nguyenvanan6724-hash/lam-tiep/kicad/esp32c6_recorder/bom.csv

Ref | Value | Footprint | Spec | MPN | Note | Qty | DNP
C26 | 10uF | Capacitor_SMD:C_0805_2012Metric | 25V X5R |  | Đặt sát chân VCC của U8 (TP4056) | 1
C27 | 10uF | Capacitor_SMD:C_0805_2012Metric | 10V X5R |  | Sát chân BAT | 1
C28 | 10uF | Capacitor_SMD:C_0603_1608Metric | 10V X5R | GRM188R61A106ME69 | Sát chân VIN (10) – GND (8) | 1
C29 | 22uF | Capacitor_SMD:C_0805_2012Metric | 10V X5R |  |  | 1
C30 | 22uF | Capacitor_SMD:C_0603_1608Metric | 10V X5R | GRM188R61A226ME15 | Sát chân VOUT (6) | 1
C31 | 22uF | Capacitor_SMD:C_0603_1608Metric | 10V X5R | GRM188R61A226ME15 |  | 1
C32 | 22uF | Capacitor_SMD:C_0805_2012Metric | 10V X5R |  | Sát chân 3V3 (pin 2) của module | 1
C33 | 100nF | Capacitor_SMD:C_0603_1608Metric |  |  | Sát chân 3V3 (pin 2) | 1
C34 | 1uF | Capacitor_SMD:C_0603_1608Metric |  |  | EN: τ = 10k × 1µF = 10 ms | 1
C35 | 100nF | Capacitor_SMD:C_0603_1608Metric |  |  | Sát chân IO2 | 1
C36 | 100nF | Capacitor_SMD:C_0603_1608Metric |  |  | Sát chân VCC (16) | 1
C37 | 100nF | Capacitor_SMD:C_0603_1608Metric |  |  | Sát chân V3 (4) | 1
C38 | 10uF | Capacitor_SMD:C_0805_2012Metric | 10V X5R |  | Sát chân VDD (4) của khe thẻ | 1
C39 | 100nF | Capacitor_SMD:C_0603_1608Metric |  |  | Sát chân VDD (4) | 1
C40 | 10uF | Capacitor_SMD:C_0805_2012Metric | 10V X5R |  |  | 1
C41 | 100nF | Capacitor_SMD:C_0603_1608Metric |  |  | Sát header MIC1 | 1
C42 | 100nF | Capacitor_SMD:C_0603_1608Metric |  |  | Sát header OLED | 1
C43 | 100nF | Capacitor_SMD:C_0603_1608Metric |  |  | Sát header MIC2 | 1
D3 | RED | LED_SMD:LED_0603_1608Metric |  |  | Sáng = đang sạc | 1
D4 | GREEN | LED_SMD:LED_0603_1608Metric |  |  | Sáng = sạc đầy | 1
D5 | SS34 | Diode_SMD:D_SMA |  | SS34 (hoặc SS14/SS24, cùng SMA) | Schottky ≥ 1 A | 1
J4 | USB-C 16P | Connector_USB:USB_C_Receptacle_HRO_TYPE-C-31-M-12 |  | HRO TYPE-C-31-M-12 | Đối chiếu đúng mã đầu cắm trước khi làm PCB | 1
J5 | microSD (DM3AT) | Connector_Card:microSD_HC_Hirose_DM3AT-SF-PEJM5 |  | Hirose DM3AT-SF-PEJM5 | Nếu đổi khe thẻ khác thì đổi cả footprint | 1
J6 | OLED I2C | Connector_PinSocket_2.54mm:PinSocket_1x04_P2.54mm_Vertical |  | Header cái 1x4 2.54 mm | Kiểm thứ tự chân: có module đảo VCC/GND | 1
J7 | LiPo 1S (có PCM) | Connector_JST:JST_PH_S2B-PH-K_1x02_P2.00mm_Horizontal |  | JST S2B-PH-K-S | Đo cực tính dây pin trước khi cắm | 1
J8,J10 | INMP441 hàng A | Connector_PinSocket_2.54mm:PinSocket_1x03_P2.54mm_Vertical |  | Header cái 1x3 2.54 mm | Đối chiếu thứ tự chân và đo khoảng cách 2 hàng chân của module | 2
J9,J11 | INMP441 hàng B | Connector_PinSocket_2.54mm:PinSocket_1x03_P2.54mm_Vertical |  | Header cái 1x3 2.54 mm | Đối chiếu thứ tự chân module | 2
L2 | 0.47uH | Inductor_SMD:L_Murata_DFE201610P | Isat ≥ 4 A, DCR ≤ 30 mΩ | Murata DFE201612E-R47M (hoặc Coilcraft XFL4015-471ME + đổi footprint) |  | 1
Q4,Q5 | MMBT3904 | Package_TO_SOT_SMD:SOT-23 |  |  |  | 2
Q6 | AO3401A | Package_TO_SOT_SMD:SOT-23 |  | AO3401A (Alpha&Omega) | D ở phía pin, S ở phía tải (bắt buộc đúng chiều) | 1
R37,R38 | 5.1k | Resistor_SMD:R_0603_1608Metric | 1% |  |  | 2
R39 | 2.4k | Resistor_SMD:R_0603_1608Metric | 1% |  | I_sạc = 1200 V / R39 = 0.5 A. Chọn lại theo dung lượng pin | 1
R40,R41 | 1k | Resistor_SMD:R_0603_1608Metric |  |  |  | 2
R42 | 511k | Resistor_SMD:R_0603_1608Metric | 1% |  |  | 1
R43 | 91k | Resistor_SMD:R_0603_1608Metric | 1% |  |  | 1
R44 | 0 | Resistor_SMD:R_0603_1608Metric |  |  | MODE thấp = tiết kiệm (PFM) | 1
R45 | 0 | Resistor_SMD:R_0603_1608Metric |  |  | DNP. Hàn R45 + bỏ R44 = PWM cố định (ít nhiễu âm thanh) | 1 | DNP
R46 | 1M | Resistor_SMD:R_0603_1608Metric |  |  | Giữ EN thấp khi công tắc đang chuyển | 1
R47,R48,R51,R55-R61 | 10k | Resistor_SMD:R_0603_1608Metric |  |  |  | 10
R49,R50 | 470k | Resistor_SMD:R_0603_1608Metric | 1% |  |  | 2
R52 | 10k | Resistor_SMD:R_0603_1608Metric |  |  | GPIO8 phải = 1 khi vào chế độ nạp | 1
R53 | 470 | Resistor_SMD:R_0603_1608Metric |  |  | TX ESP32 → RX CH340 | 1
R54 | 470 | Resistor_SMD:R_0603_1608Metric |  |  | TX CH340 → RX ESP32 | 1
R62,R68,R69 | 22 | Resistor_SMD:R_0603_1608Metric |  |  | Sát chân ESP32 | 3
R63 | 100k | Resistor_SMD:R_0603_1608Metric |  |  | Kéo xuống đường SD (datasheet) | 1
R64 | 22 | Resistor_SMD:R_0603_1608Metric |  |  | Lọc RC nguồn mic | 1
R65,R66 | 5.1k | Resistor_SMD:R_0603_1608Metric |  |  | Module đã có pull-up thì có thể bỏ (DNP) | 2
R67 | 10k | Resistor_SMD:R_0603_1608Metric |  |  | Kéo gate xuống khi rút USB | 1
SW5 | POWER | Button_Switch_SMD:SW_SPDT_Shouhan_MSK12C02 |  | MSK-12C02 (gạt 3 chân) |  | 1
SW6 | USER | Button_Switch_SMD:SW_Push_1P1T_XKB_TS-1187A |  | TS-1187A |  | 1
SW7 | RESET | Button_Switch_SMD:SW_Push_1P1T_XKB_TS-1187A |  | TS-1187A |  | 1
SW8 | BOOT | Button_Switch_SMD:SW_Push_1P1T_XKB_TS-1187A |  | TS-1187A |  | 1
U7 | USBLC6-2SC6 | Package_TO_SOT_SMD:SOT-23-6 |  | ST USBLC6-2SC6 | Đặt sát cổng USB | 1
U8 | TP4056 | Package_SO:SOIC-8-1EP_3.9x4.9mm_P1.27mm_EP2.41x3.3mm_ThermalVias |  | TP4056-42-ESOP8 (NanJing Top Power) | Pad tản nhiệt (EPAD) hàn xuống GND + via | 1
U9 | TPS63802 | esp32c6_rec:Texas_DLA0010A_VSON-HR-10_2x3mm_P0.5mm |  | TPS63802DLAR (TI) | Footprint tự vẽ theo land pattern DLA0010A, kiểm lại trước khi đặt mạch | 1
U10 | ESP32-C6-WROOM-1-N8 | esp32c6_rec:ESP32-C6-WROOM-1 |  | ESP32-C6-WROOM-1-N8 (Espressif) | Ăng-ten ra mép board, cấm đồng dưới ăng-ten | 1
U11 | CH340C | Package_SO:SOIC-16_3.9x9.9mm_P1.27mm |  | WCH CH340C | VCC = V3 = 3.3 V (cấu hình 3.3 V) | 1
