nguyenvanan6724-hash/lam-tiep/schematic_rev_B.pdf

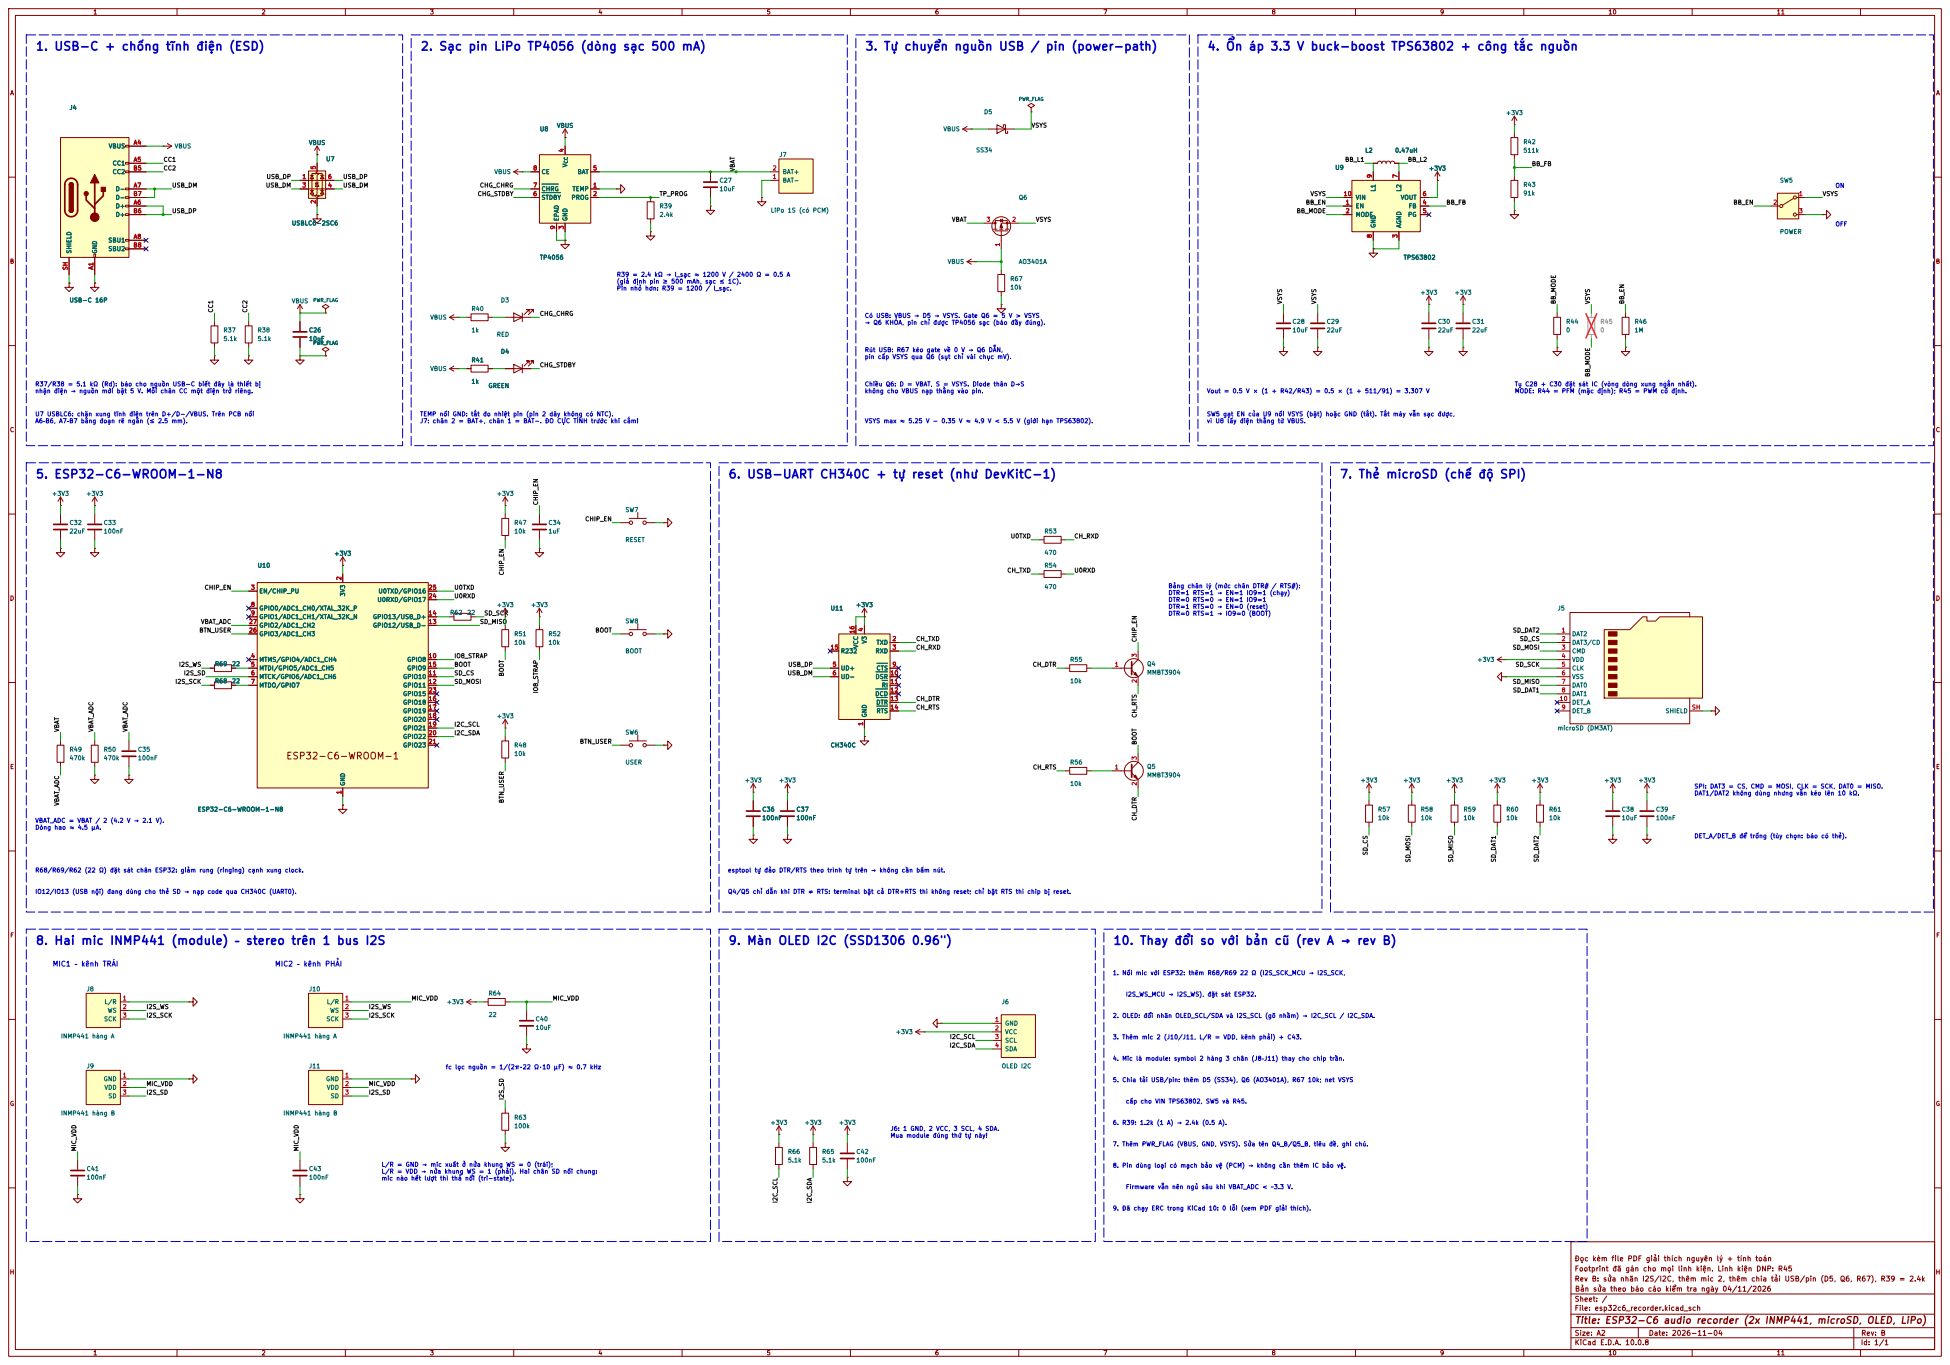
[picture p33: page 1]

4. Ổn áp 3.3 V buck-boost TPS63802 + công tắc nguồn

1. USB-C + chống tĩnh điện (ESD)
J4USB-C 16PGND A1

2. Sạc pin LiPo TP4056 (dòng sạc 500 mA)

3. Tự chuyển nguồn USB / pin (power-path)

OFF Chiều Q6: D = VBAT, S = VSYS. Diode thân D→S

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

A6–B6, A7–B7 bằng đoạn rẽ ngắn (≤ 2.5 mm).

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

R68/R69/R62 (22 Ω) đặt sát chân ESP32: giảm rung (ringing) cạnh xung clock. VBAT_ADC = VBAT / 2 (4.2 V → 2.1 V).
Dòng hao ≈ 4.5 µA.

IO12/IO13 (USB nội) đang dùng cho thẻ SD → nạp code qua CH340C (UART0).

FGH
8. Hai mic INMP441 (module) – stereo trên 1 bus I2S
INMP441 hàng A C41

10. Thay đổi so với bản cũ (rev A → rev B)

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

3. Thêm mic 2 (J10/J11, L/R = VDD, kênh phải) + C43. 7. Thêm PWR_FLAG (VBUS, GND, VSYS). Sửa tên Q4_B/Q5_B, tiêu đề, ghi chú. 2. OLED: đổi nhãn OLED_SCL/SDA và I2S_SCL (gõ nhầm) → I2C_SCL / I2C_SDA. 5. Chia tải USB/pin: thêm D5 (SS34), Q6 (AO3401A), R67 10k; net VSYS

fc lọc nguồn = 1/(2π·22 Ω·10 µF) ≈ 0.7 kHz

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

J6: 1 GND, 2 VCC, 3 SCL, 4 SDA. Mua module đúng thứ tự này!

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

Đọc kèm file PDF giải thích nguyên lý + tính toán
Footprint đã gán cho mọi linh kiện. Linh kiện DNP: R45
Rev B: sửa nhãn I2S/I2C, thêm mic 2, thêm chia tải USB/pin (D5, Q6, R67), R39 = 2.4k
Bản sửa theo báo cáo kiểm tra ngày 04/11/2026
Sheet: /
File: esp32c6_recorder.kicad_sch
Title: ESP32-C6 audio recorder (2x INMP441, microSD, OLED, LiPo)

Size: A2 | Rev: B
KiCad E.D.A. 10.0.8 | Id: 1/1
