nguyenvanan6724-hash/lam-tiep/esp32_c6_project.pdf

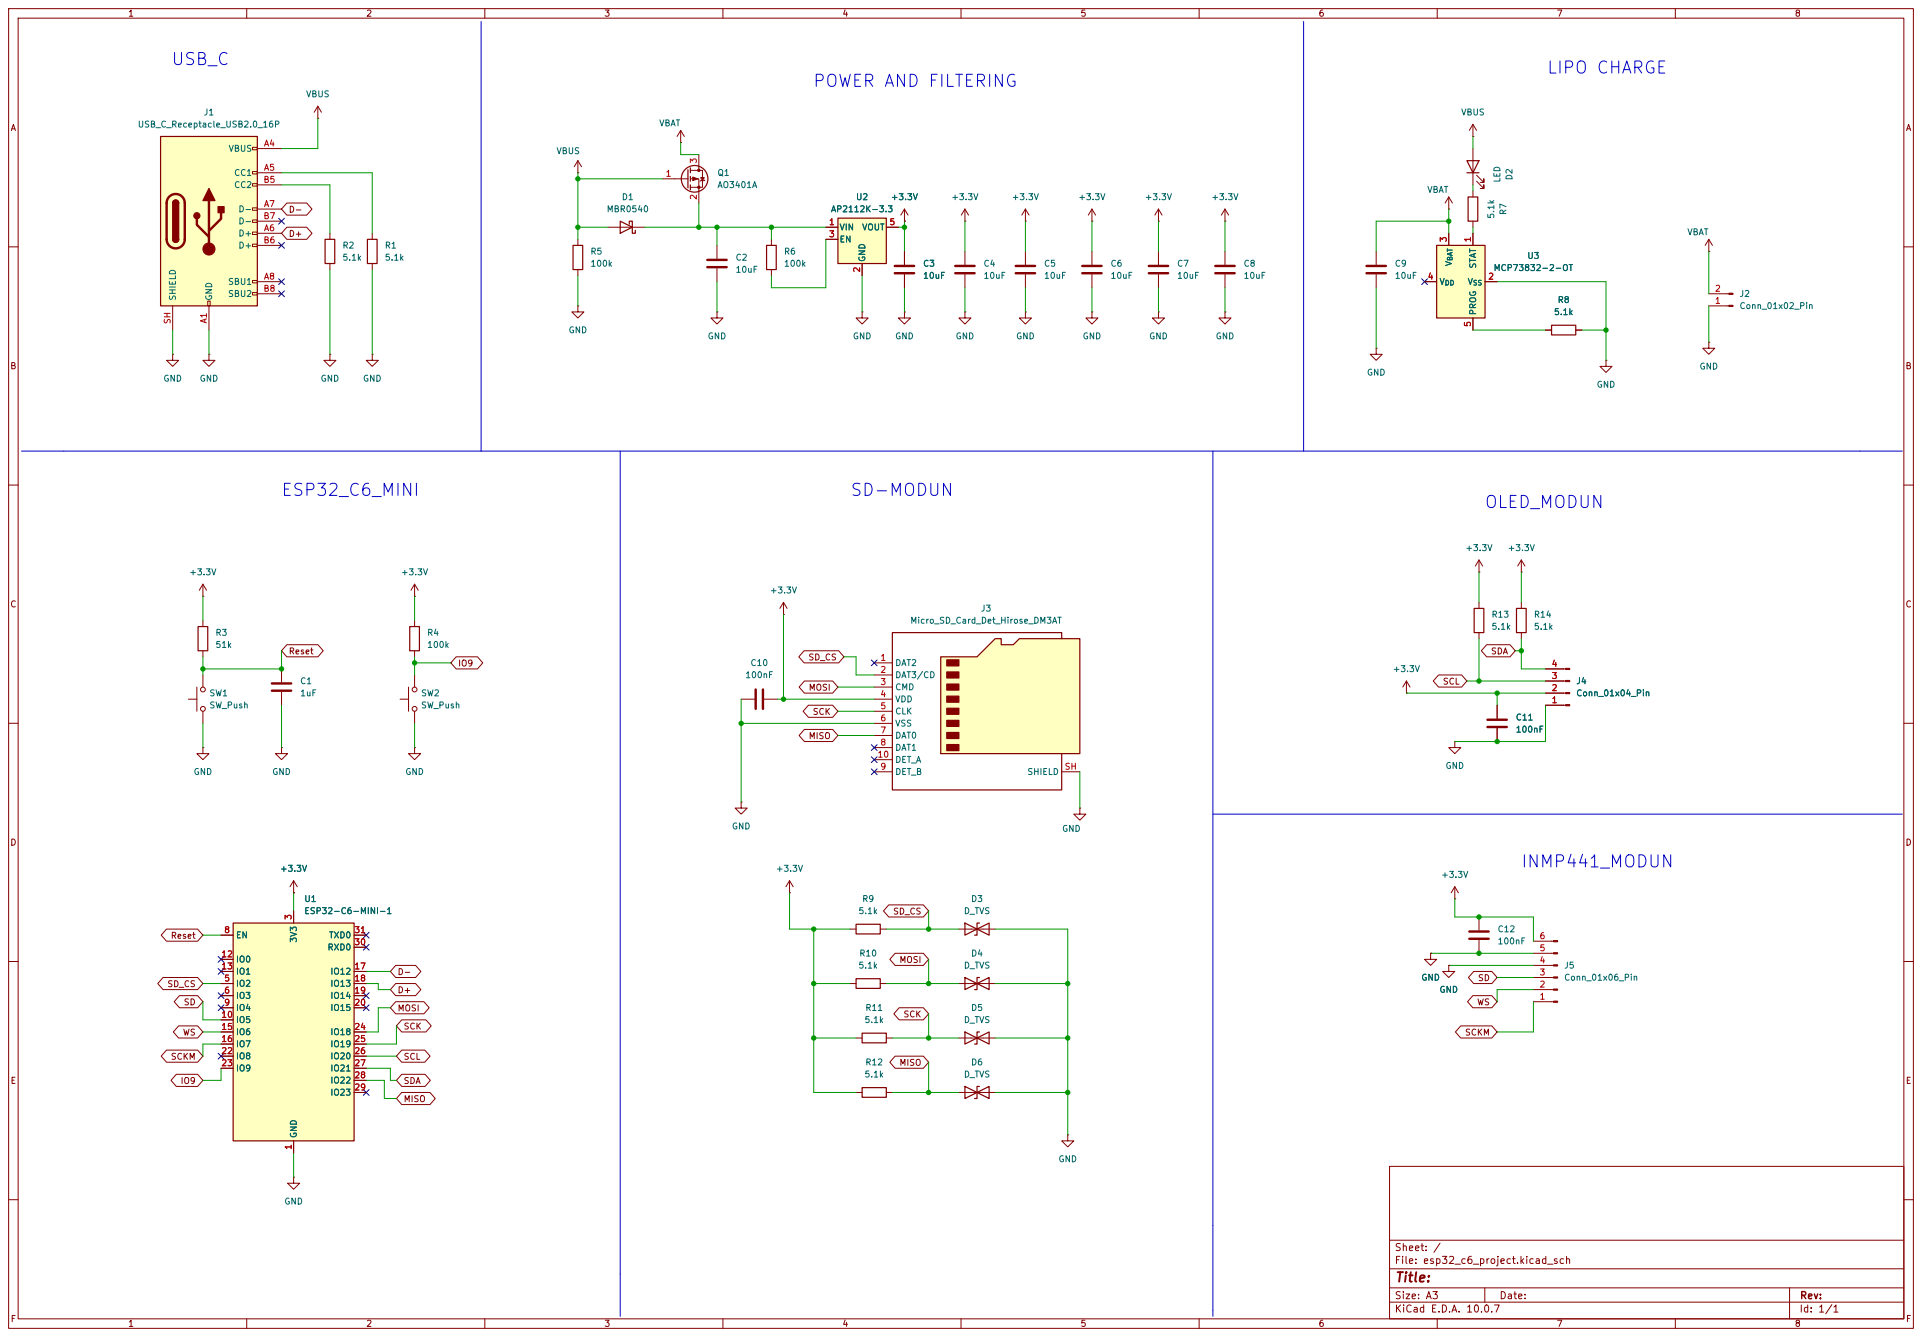
[picture p34: page 1]

Size: A3 | Rev: | F Date:
KiCad E.D.A. 10.0.7 | Id: 1/1
