nguyenvanan6724-hash/lam-tiep/kicad/esp32c6_recorder/esp32c6_recorder.kicad_sch

## KiCad design kicad/esp32c6_recorder/esp32c6_recorder.kicad_sch (2026-11-04)

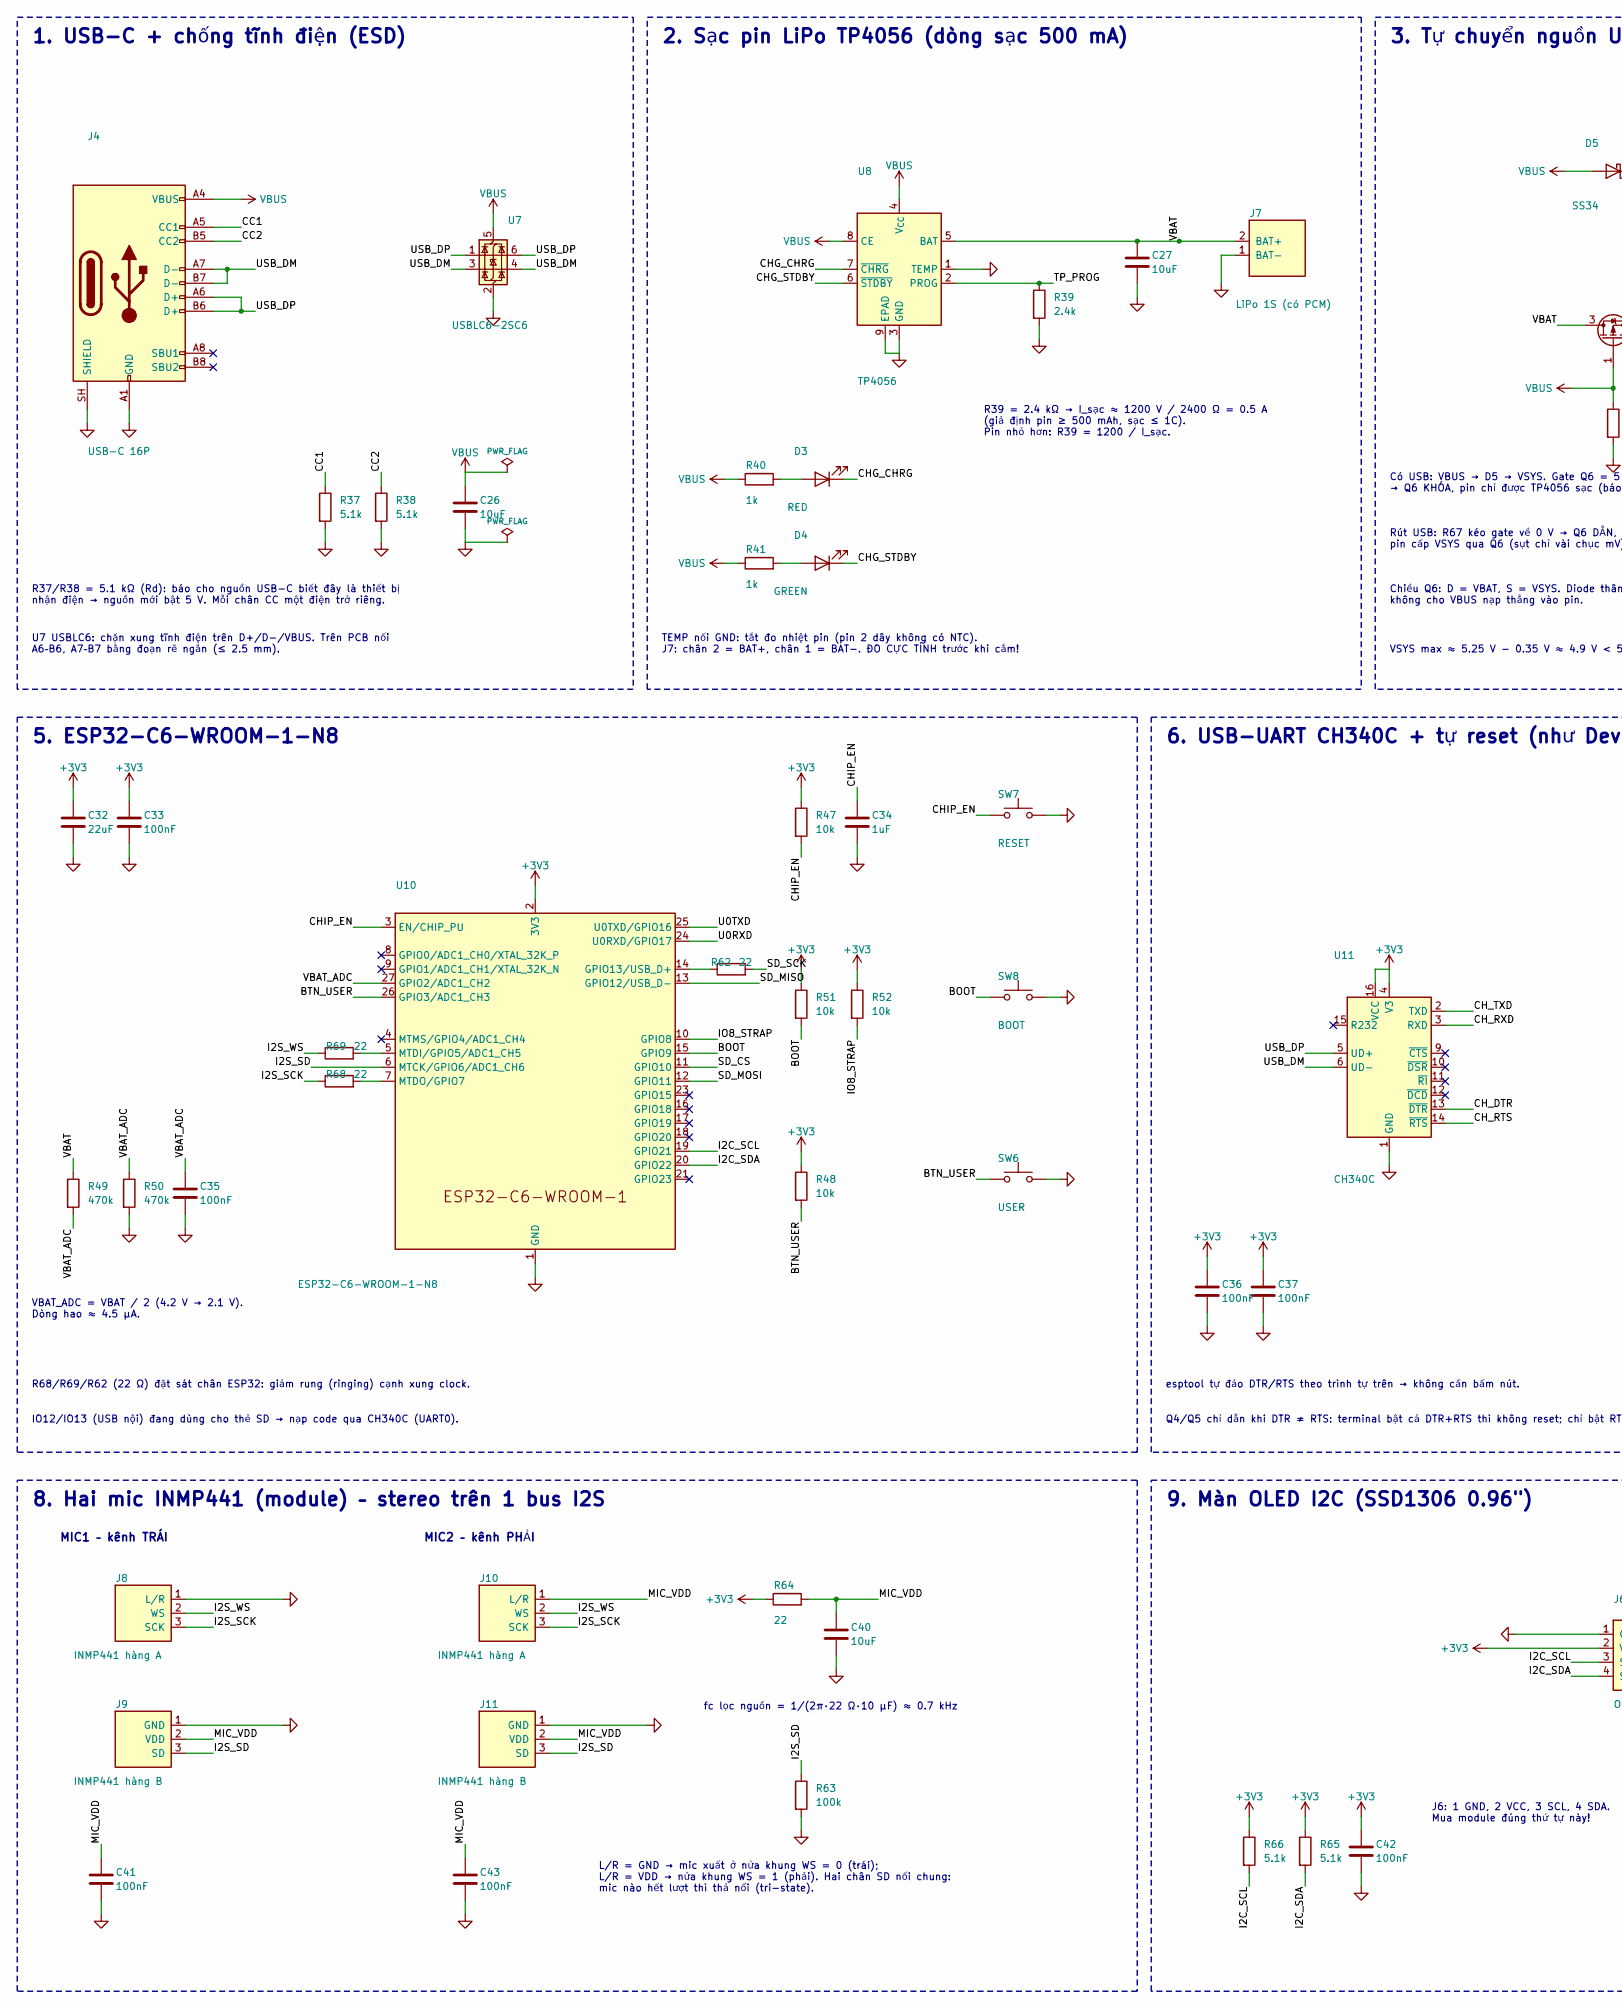
[picture p35: schematic esp32c6_recorder.kicad_sch, part in row 1, column 1]

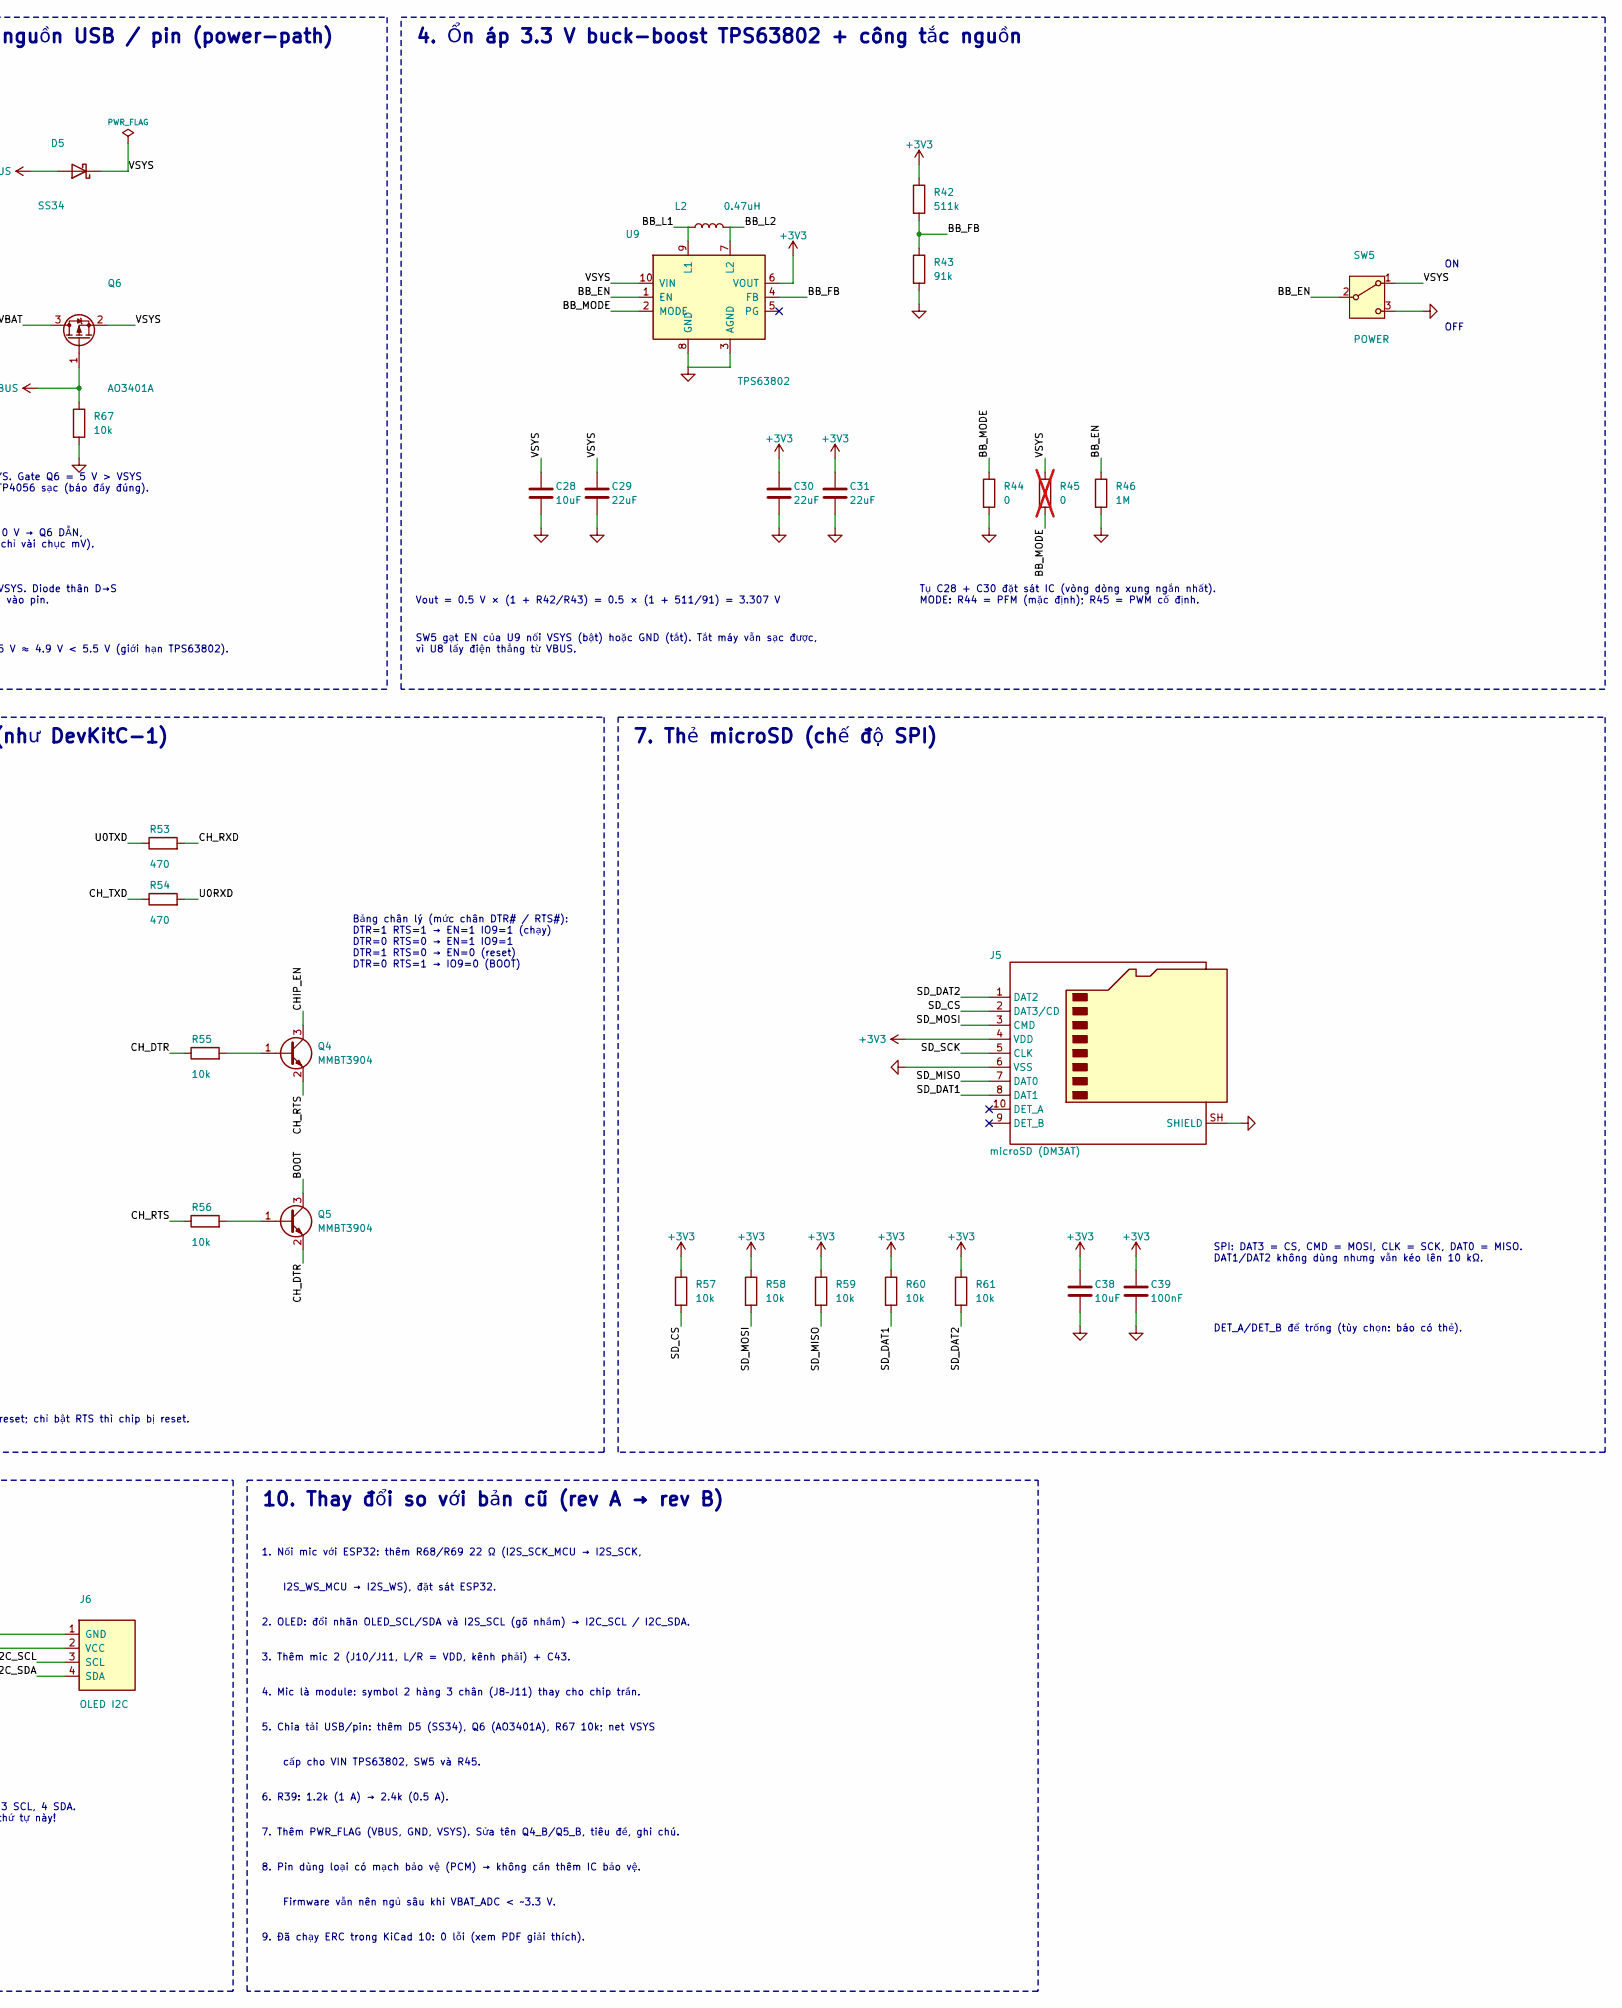
[picture p36: schematic esp32c6_recorder.kicad_sch, part in row 1, column 2]

Parts:
C26, C27, C38, C40: 10uF; C_0805_2012Metric
C28: 10uF; C_0603_1608Metric; MPN GRM188R61A106ME69
C29, C32: 22uF; C_0805_2012Metric
C30, C31: 22uF; C_0603_1608Metric; MPN GRM188R61A226ME15
C33, C35, C36, C37, C39, C41, C42, C43: 100nF; C_0603_1608Metric
C34: 1uF; C_0603_1608Metric
D3: RED; LED_0603_1608Metric
D4: GREEN; LED_0603_1608Metric
D5: SS34; D_SMA; MPN SS34 (hoặc SS14/SS24, cùng SMA)
J4: USB-C 16P; USB_C_Receptacle_HRO_TYPE-C-31-M-12; MPN HRO TYPE-C-31-M-12
J5: microSD (DM3AT); microSD_HC_Hirose_DM3AT-SF-PEJM5; MPN Hirose DM3AT-SF-PEJM5
J6: OLED I2C; PinSocket_1x04_P2.54mm_Vertical; MPN Header cái 1x4 2.54 mm
J7: LiPo 1S (có PCM); JST_PH_S2B-PH-K_1x02_P2.00mm_Horizontal; MPN JST S2B-PH-K-S
J8, J10: INMP441 hàng A; PinSocket_1x03_P2.54mm_Vertical; MPN Header cái 1x3 2.54 mm
J9, J11: INMP441 hàng B; PinSocket_1x03_P2.54mm_Vertical; MPN Header cái 1x3 2.54 mm
L2: 0.47uH; L_Murata_DFE201610P; MPN Murata DFE201612E-R47M (hoặc Coilcraft 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
Q4, Q5: MMBT3904; SOT-23
Q6: AO3401A; SOT-23; MPN AO3401A (Alpha&Omega)
R37, R38, R65, R66: 5.1k; R_0603_1608Metric
R39: 2.4k; R_0603_1608Metric
R40, R41: 1k; R_0603_1608Metric
R42: 511k; R_0603_1608Metric
R43: 91k; R_0603_1608Metric
R44: 0; R_0603_1608Metric
R45: 0; R_0603_1608Metric; not fitted
R46: 1M; R_0603_1608Metric
R47, R48, R51, R52, R55, R56, R57, R58, R59, R60, R61, R67: 10k; R_0603_1608Metric
R49, R50: 470k; R_0603_1608Metric
R53, R54: 470; R_0603_1608Metric
R62, R64, R68, R69: 22; R_0603_1608Metric
R63: 100k; R_0603_1608Metric
SW5: POWER; SW_SPDT_Shouhan_MSK12C02; MPN MSK-12C02 (gạt 3 chân)
SW6: USER; SW_Push_1P1T_XKB_TS-1187A; MPN TS-1187A
SW7: RESET; SW_Push_1P1T_XKB_TS-1187A; MPN TS-1187A
SW8: BOOT; SW_Push_1P1T_XKB_TS-1187A; MPN TS-1187A
U7: USBLC6-2SC6; SOT-23-6; MPN ST USBLC6-2SC6
U8: TP4056; SOIC-8-1EP_3.9x4.9mm_P1.27mm_EP2.41x3.3mm_ThermalVias; MPN TP4056-42-ESOP8 (NanJing Top Power)
U9: TPS63802; Texas_DLA0010A_VSON-HR-10_2x3mm_P0.5mm; MPN TPS63802DLAR (TI)
U10: ESP32-C6-WROOM-1-N8; ESP32-C6-WROOM-1; MPN ESP32-C6-WROOM-1-N8 (Espressif)
U11: CH340C; SOIC-16_3.9x9.9mm_P1.27mm; MPN WCH CH340C

Connections:
+3V3: C30.1, C31.1, C32.1, C33.1, C36.1, C37.1, C38.1, C39.1, C42.1, J5.4 (VDD), J6.2 (VCC), R42.1, R47.1, R48.1, R51.1, R52.1, R57.1, R58.1, R59.1, R60.1, R61.1, R64.1, R65.1, R66.1, U9.6 (VOUT), U10.2 (3V3), U11.4 (V3), U11.16 (VCC)
BB_EN: R46.1, SW5.2 (B), U9.1 (EN)
BB_FB: R42.2, R43.1, U9.4 (FB)
BB_L1: L2.1, U9.9 (L1)
BB_L2: L2.2, U9.7 (L2)
BB_MODE: R44.1, R45.2, U9.2 (MODE)
BOOT: Q5.3 (C), R51.2, SW8.1, U10.15 (GPIO9)
BTN_USER: R48.2, SW6.1, U10.26 (GPIO3/ADC1_CH3)
CC1: J4.A5 (CC1), R37.1
CC2: J4.B5 (CC2), R38.1
CHG_CHRG: D3.1 (K), U8.7 (~CHRG)
CHG_STDBY: D4.1 (K), U8.6 (~STDBY)
CHIP_EN: C34.1, Q4.3 (C), R47.2, SW7.1, U10.3 (EN/CHIP_PU)
CH_DTR: Q5.2 (E), R55.1, U11.13 (~DTR)
CH_RTS: Q4.2 (E), R56.1, U11.14 (~RTS)
CH_RXD: R53.2, U11.3 (RXD)
CH_TXD: R54.1, U11.2 (TXD)
GND: C26.2, C27.2, C28.2, C29.2, C30.2, C31.2, C32.2, C33.2, C34.2, C35.2, C36.2, C37.2, C38.2, C39.2, C40.2, C41.2, C42.2, C43.2, J4.A1 (GND), J4.A12 (GND), J4.B1 (GND), J4.B12 (GND), J4.SH (SHIELD), J5.6 (VSS), J5.SH (SHIELD), J6.1 (GND), J7.1 (BAT-), J8.1 (L/R), J9.1 (GND), J11.1 (GND), R37.2, R38.2, R39.2, R43.2, R44.2, R46.2, R50.2, R63.2, R67.2, SW5.3 (C), SW6.2, SW7.2, SW8.2, U7.2 (GND), U8.1 (TEMP), U8.3 (GND), U8.9 (EPAD), U9.3 (AGND), U9.8 (GND), U10.1 (GND), U10.28 (GND), U10.29 (GND), U11.1 (GND)
I2C_SCL: J6.3 (SCL), R66.2, U10.19 (GPIO21)
I2C_SDA: J6.4 (SDA), R65.2, U10.20 (GPIO22)
I2S_SCK: J8.3 (SCK), J10.3 (SCK), R68.1
I2S_SD: J9.3 (SD), J11.3 (SD), R63.1, U10.6 (MTCK/GPIO6/ADC1_CH6)
I2S_WS: J8.2 (WS), J10.2 (WS), R69.1
IO8_STRAP: R52.2, U10.10 (GPIO8)
MIC_VDD: C40.1, C41.1, C43.1, J9.2 (VDD), J10.1 (L/R), J11.2 (VDD), R64.2
unnamed: D3.2 (A), R40.2
unnamed: D4.2 (A), R41.2
unnamed: Q4.1 (B), R55.2
unnamed: Q5.1 (B), R56.2
unnamed: R62.1, U10.14 (GPIO13/USB_D+)
unnamed: R68.2, U10.7 (MTDO/GPIO7)
unnamed: R69.2, U10.5 (MTDI/GPIO5/ADC1_CH5)
SD_CS: J5.2 (DAT3/CD), R57.2, U10.11 (GPIO10)
SD_DAT1: J5.8 (DAT1), R60.2
SD_DAT2: J5.1 (DAT2), R61.2
SD_MISO: J5.7 (DAT0), R59.2, U10.13 (GPIO12/USB_D-)
SD_MOSI: J5.3 (CMD), R58.2, U10.12 (GPIO11)
SD_SCK: J5.5 (CLK), R62.2
TP_PROG: R39.1, U8.2 (PROG)
U0RXD: R54.2, U10.24 (U0RXD/GPIO17)
U0TXD: R53.1, U10.25 (U0TXD/GPIO16)
USB_DM: J4.A7 (D-), J4.B7 (D-), U7.3 (I/O2), U7.4 (I/O2), U11.6 (UD-)
USB_DP: J4.A6 (D+), J4.B6 (D+), U7.1 (I/O1), U7.6 (I/O1), U11.5 (UD+)
VBAT: C27.1, J7.2 (BAT+), Q6.3 (D), R49.1, U8.5 (BAT)
VBAT_ADC: C35.1, R49.2, R50.1, U10.27 (GPIO2/ADC1_CH2)
VBUS: C26.1, D5.2 (A), J4.A4 (VBUS), J4.A9 (VBUS), J4.B4 (VBUS), J4.B9 (VBUS), Q6.1 (G), R40.1, R41.1, R67.1, U7.5 (VBUS), U8.4 (V_{CC}), U8.8 (CE)
VSYS: C28.1, C29.1, D5.1 (K), Q6.2 (S), R45.1, SW5.1 (A), U9.10 (VIN)

Notes on the sheet:
5. Chia tải USB/pin: thêm D5 (SS34), Q6 (AO3401A), R67 10k; net VSYS
Tụ C28 + C30 đặt sát IC (vòng dòng xung ngắn nhất). MODE: R44 = PFM (mặc định); R45 = PWM cố định.
Rút USB: R67 kéo gate về 0 V → Q6 DẪN, pin cấp VSYS qua Q6 (sụt chỉ vài chục mV).
L/R = GND → mic xuất ở nửa khung WS = 0 (trái); L/R = VDD → nửa khung WS = 1 (phải). Hai chân SD nối chung: mic nào hết lượt thì thả nổi (tri-state).
2. OLED: đổi nhãn OLED_SCL/SDA và I2S_SCL (gõ nhầm) → I2C_SCL / I2C_SDA.
VBAT_ADC = VBAT / 2 (4.2 V → 2.1 V). Dòng hao ≈ 4.5 µA.
1. USB-C + chống tĩnh điện (ESD)
5. ESP32-C6-WROOM-1-N8
MIC2 – kênh PHẢI
8. Hai mic INMP441 (module) – stereo trên 1 bus I2S
6. USB-UART CH340C + tự reset (như DevKitC-1)
7. Thêm PWR_FLAG (VBUS, GND, VSYS). Sửa tên Q4_B/Q5_B, tiêu đề, ghi chú.
2. Sạc pin LiPo TP4056 (dòng sạc 500 mA)
I2S_WS_MCU → I2S_WS), đặt sát ESP32.
cấp cho VIN TPS63802, SW5 và R45.
DET_A/DET_B để trống (tùy chọn: báo có thẻ).
Có USB: VBUS → D5 → VSYS. Gate Q6 = 5 V > VSYS → Q6 KHÓA, pin chỉ được TP4056 sạc (báo đầy đúng).
1. Nối mic với ESP32: thêm R68/R69 22 Ω (I2S_SCK_MCU → I2S_SCK,
6. R39: 1.2k (1 A) → 2.4k (0.5 A).
OFF
Bảng chân lý (mức chân DTR# / RTS#): DTR=1 RTS=1 → EN=1 IO9=1 (chạy) DTR=0 RTS=0 → EN=1 IO9=1 DTR=1 RTS=0 → EN=0 (reset) DTR=0 RTS=1 → IO9=0 (BOOT)
J6: 1 GND, 2 VCC, 3 SCL, 4 SDA. Mua module đúng thứ tự này!
3. Tự chuyển nguồn USB / pin (power-path)
R68/R69/R62 (22 Ω) đặt sát chân ESP32: giảm rung (ringing) cạnh xung clock.
9. Đã chạy ERC trong KiCad 10: 0 lỗi (xem PDF giải thích).
3. Thêm mic 2 (J10/J11, L/R = VDD, kênh phải) + C43.
fc lọc nguồn = 1/(2π·22 Ω·10 µF) ≈ 0.7 kHz
IO12/IO13 (USB nội) đang dùng cho thẻ SD → nạp code qua CH340C (UART0).
Firmware vẫn nên ngủ sâu khi VBAT_ADC < ~3.3 V.
Q4/Q5 chỉ dẫn khi DTR ≠ RTS: terminal bật cả DTR+RTS thì không reset; chỉ bật RTS thì chip bị reset.
Chiều Q6: D = VBAT, S = VSYS. Diode thân D→S không cho VBUS nạp thẳng vào pin.
7. Thẻ microSD (chế độ SPI)
4. Ổn áp 3.3 V buck-boost TPS63802 + công tắc nguồn
U7 USBLC6: chặn xung tĩnh điện trên D+/D−/VBUS. Trên PCB nối A6–B6, A7–B7 bằng đoạn rẽ ngắn (≤ 2.5 mm).
10. Thay đổi so với bản cũ (rev A → rev B)
8. Pin dùng loại có mạch bảo vệ (PCM) → không cần thêm IC bảo vệ.
9. Màn OLED I2C (SSD1306 0.96")
SW5 gạt EN của U9 nối VSYS (bật) hoặc GND (tắt). Tắt máy vẫn sạc được, vì U8 lấy điện thẳng từ VBUS.
Vout = 0.5 V × (1 + R42/R43) = 0.5 × (1 + 511/91) = 3.307 V
MIC1 – kênh TRÁI
R37/R38 = 5.1 kΩ (Rd): báo cho nguồn USB-C biết đây là thiết bị nhận điện → nguồn mới bật 5 V. Mỗi chân CC một điện trở riêng.
SPI: DAT3 = CS, CMD = MOSI, CLK = SCK, DAT0 = MISO. DAT1/DAT2 không dùng nhưng vẫn kéo lên 10 kΩ.
4. Mic là module: symbol 2 hàng 3 chân (J8–J11) thay cho chip trần.
VSYS max ≈ 5.25 V − 0.35 V ≈ 4.9 V < 5.5 V (giới hạn TPS63802).
esptool tự đảo DTR/RTS theo trình tự trên → không cần bấm nút.
R39 = 2.4 kΩ → I_sạc ≈ 1200 V / 2400 Ω = 0.5 A (giả định pin ≥ 500 mAh, sạc ≤ 1C). Pin nhỏ hơn: R39 = 1200 / I_sạc.
TEMP nối GND: tắt đo nhiệt pin (pin 2 dây không có NTC). J7: chân 2 = BAT+, chân 1 = BAT−. ĐO CỰC TÍNH trước khi cắm!
